ElectroTodos/ElectronicLoad/README.md

# ElectronicLoad
ElectronicLoad
youtube.com/electronicatodos/
https://www.youtube.com/playlist?list=PLbbu5mf7ZIfhO1j8X4gU5TwYUcYao87rT
