ElectroTodos/ElectronicLoad/PDFs/RevAPCB.pdf

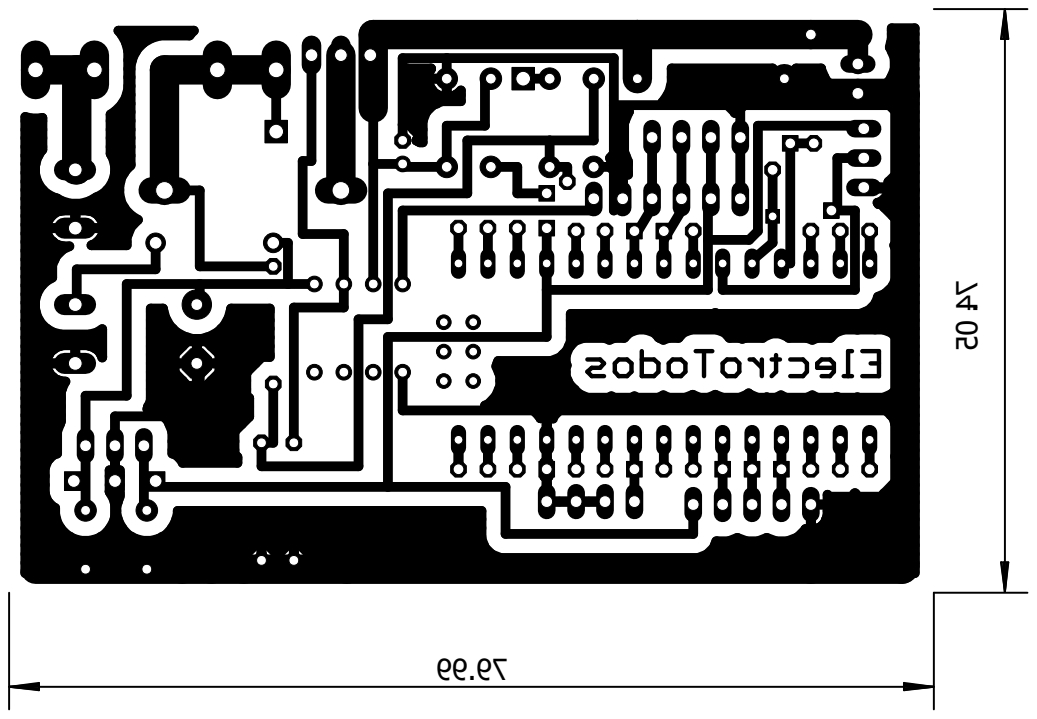
[picture p1: page 1]
