ElectroTodos/ElectronicLoad/PDFs/RevAPCBInfo.pdf

Q1

## IRLZ44Z

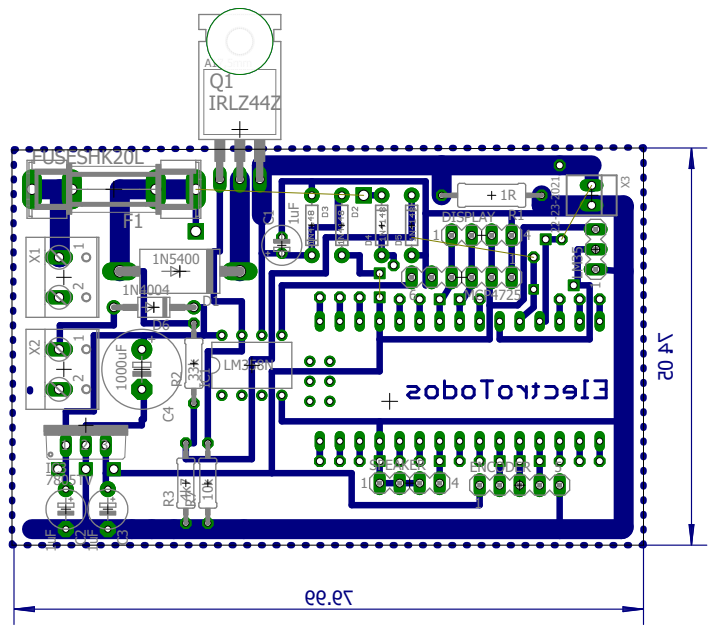
[picture p2: page 1]
