ElectroTodos/ElectronicLoad/PDFs/RevASch.pdf

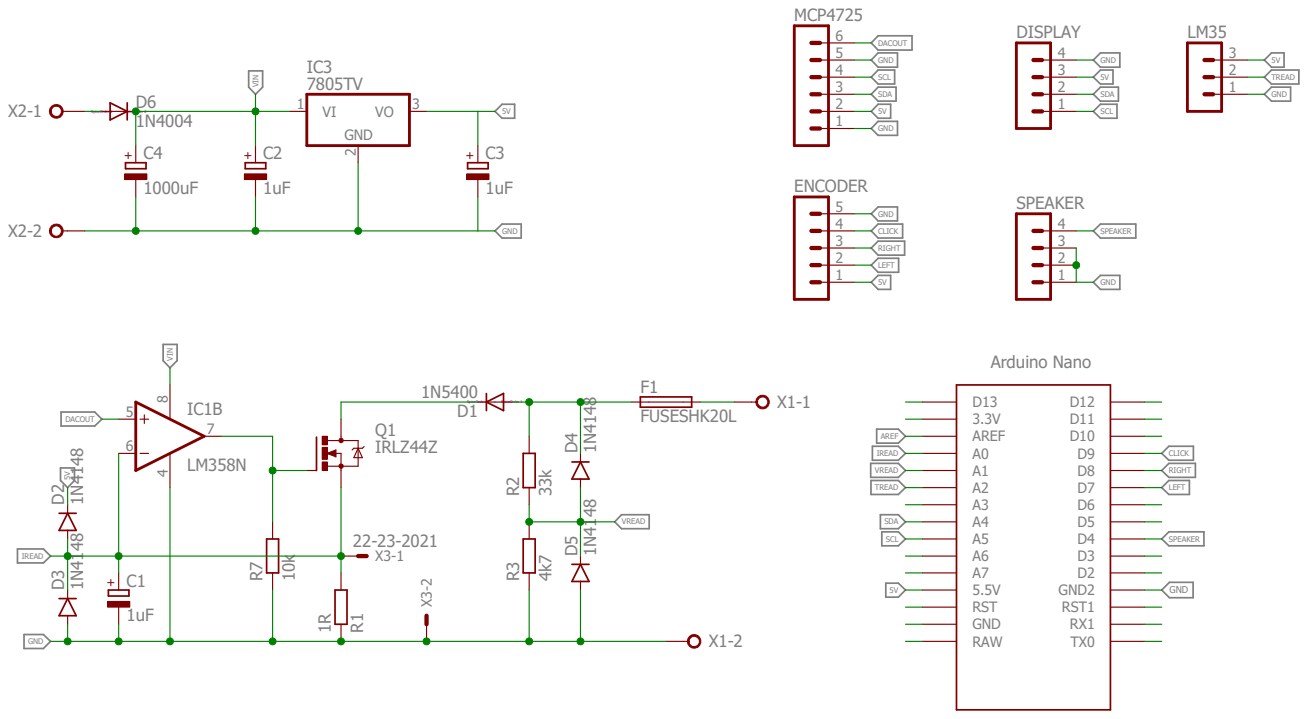
[picture p3: page 1]
