ElectroTodos/ElectronicLoad/RevA/RevA.brd

## EAGLE design RevA/RevA.brd (2016-07-01, an earlier design)

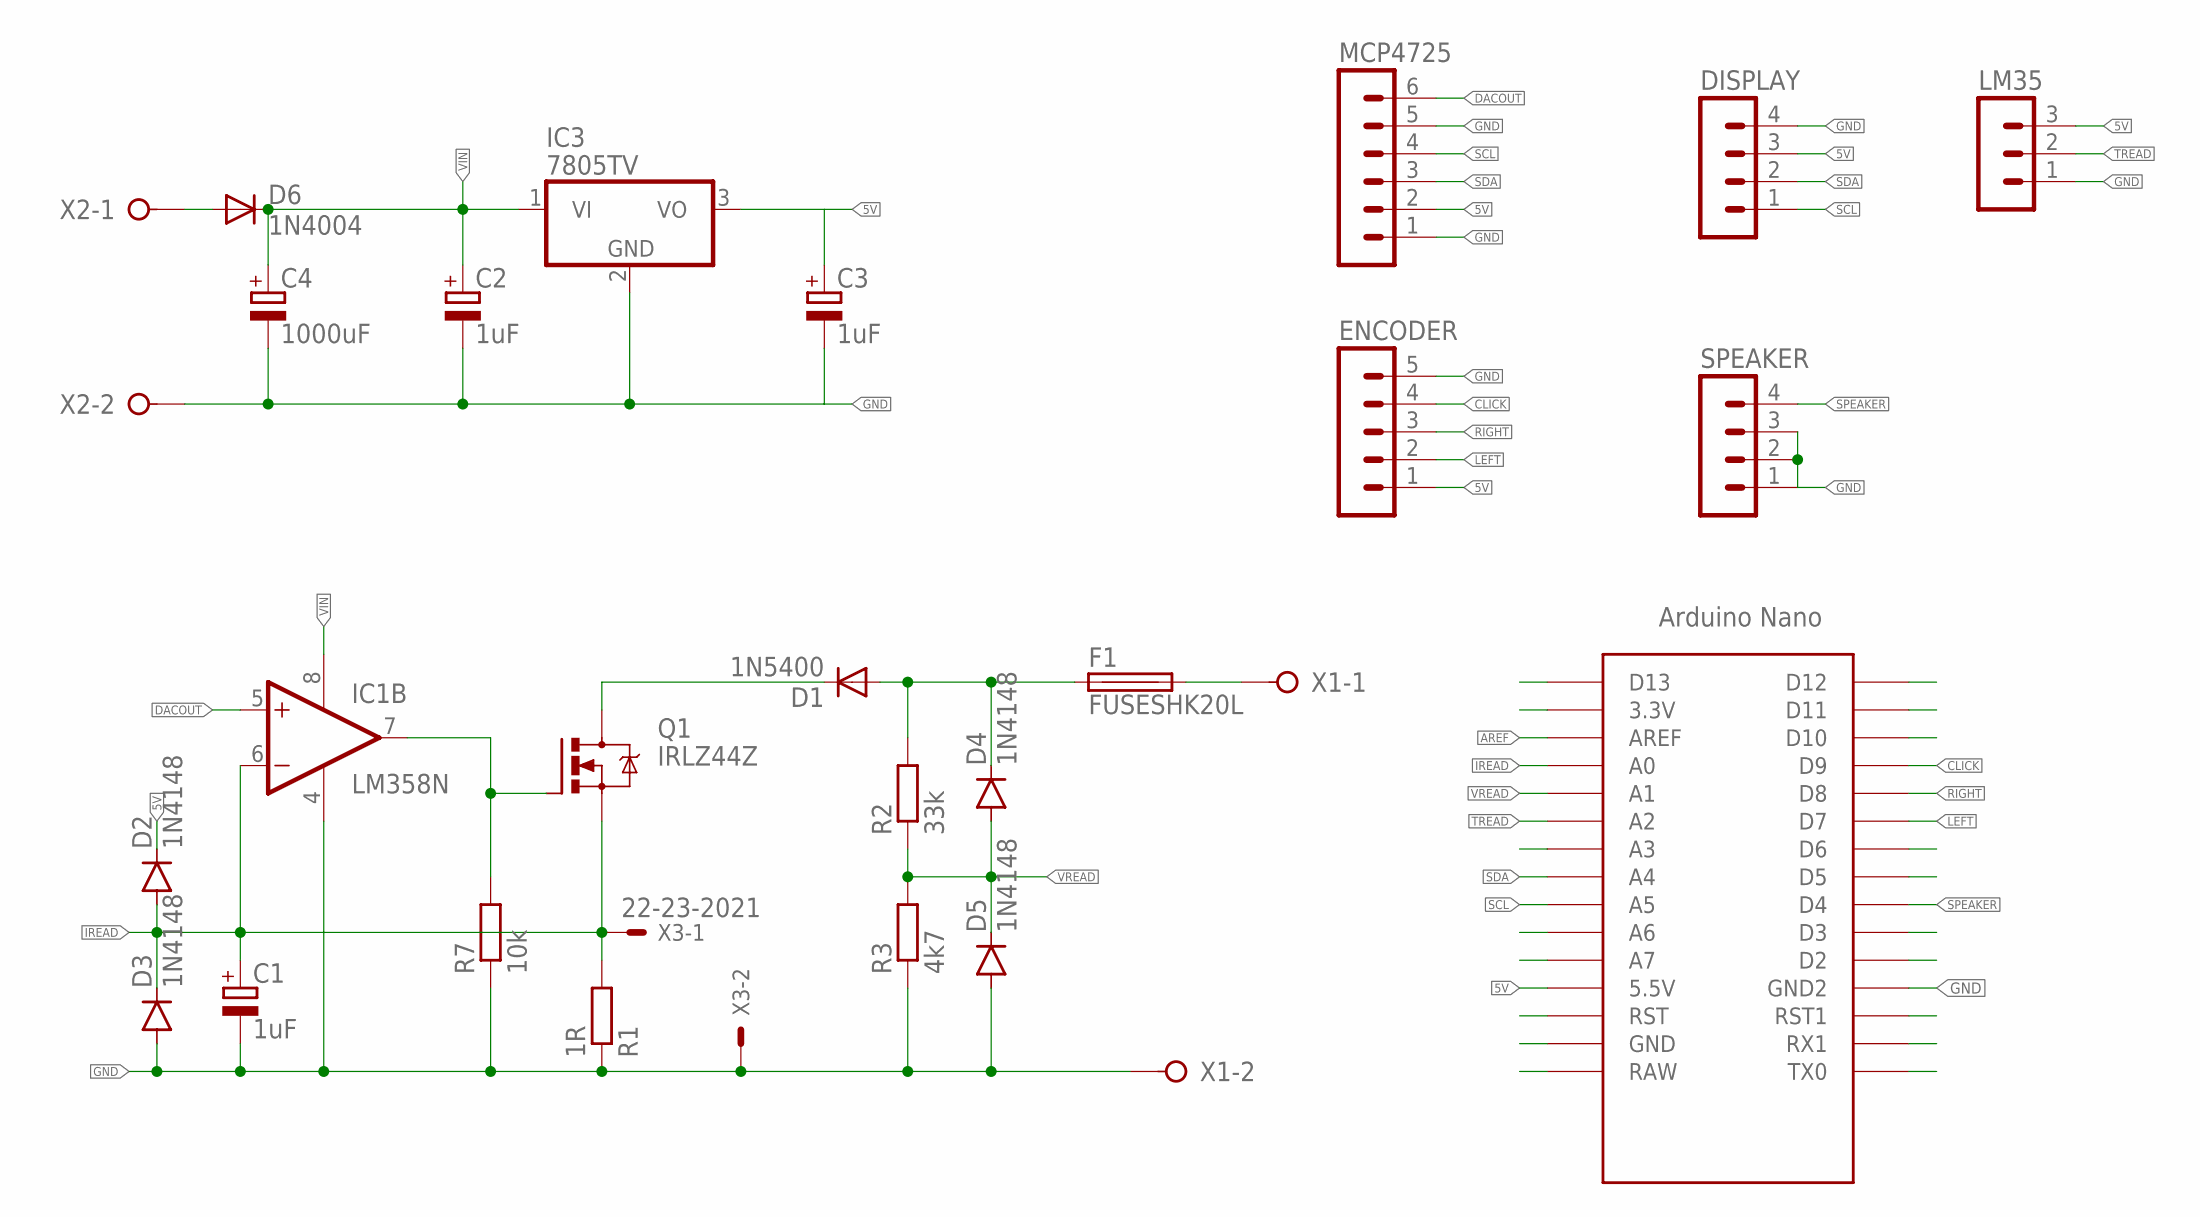
[picture p4: schematic RevA.sch]

Parts:
C1: 1uF; E2-5
C2, C3: 1uF; E5-5
C4: 1000uF; E5-10,5
D1: 1N5400; DO201-15
D2, D3, D4, D5: 1N4148; DIODE-1N4148
D6: 1N4004; DO41-10
DISPLAY: MA04-1
ENCODER: MA05-1
F1: FUSESHK20L; SHK20L
IC1: LM358N; DIL08
IC3: 7805TV; TO220V
LM35: MA03-1
MCP4725: MA06-1
Q1: IRLZ44Z; TO220BH
R1: 1R; 0309/12
R2: 33k; 0207/10
R3: 4k7; 0207/10
R7: 10k; 0207/10
SPEAKER: MA04-1
U$1: NANO
X1, X2: W237-02P; W237-132
X3: 22-23-2021

Connections:
5V: C3.+, D2.C, DISPLAY.3, ENCODER.1, IC3.3 (VO), LM35.3, MCP4725.2, U$1.5V (5.5V)
AREF: U$1.AREF
CLICK: ENCODER.4, U$1.D9
DACOUT: IC1.5 (+IN), MCP4725.6
GND: C1.-, C2.-, C3.-, C4.-, D3.A, D5.A, DISPLAY.4, ENCODER.5, IC1.4 (V-), IC3.2 (GND), LM35.1, MCP4725.1, MCP4725.5, R1.1, R3.1, R7.1, SPEAKER.1, SPEAKER.2, SPEAKER.3, U$1.GND1 (GND2), X1.2, X2.2, X3.2
IREAD: C1.+, D2.A, D3.C, IC1.6 (-IN), Q1.S, R1.2, U$1.A0, X3.1
LEFT: ENCODER.2, U$1.D7
unnamed: F1.2A (2), X1.1
unnamed: D1.A, D4.C, F1.1A (1), R2.2
unnamed: IC1.7 (OUT), Q1.G, R7.2
unnamed: D6.A, X2.1
unnamed: D1.C, Q1.D
RIGHT: ENCODER.3, U$1.D8
SCL: DISPLAY.1, MCP4725.4, U$1.A5
SDA: DISPLAY.2, MCP4725.3, U$1.A4
SPEAKER: SPEAKER.4, U$1.D4
TREAD: LM35.2, U$1.A2
VIN: C2.+, C4.+, D6.C, IC1.8 (V+), IC3.1 (VI)
VREAD: D4.A, D5.C, R2.1, R3.2, U$1.A1

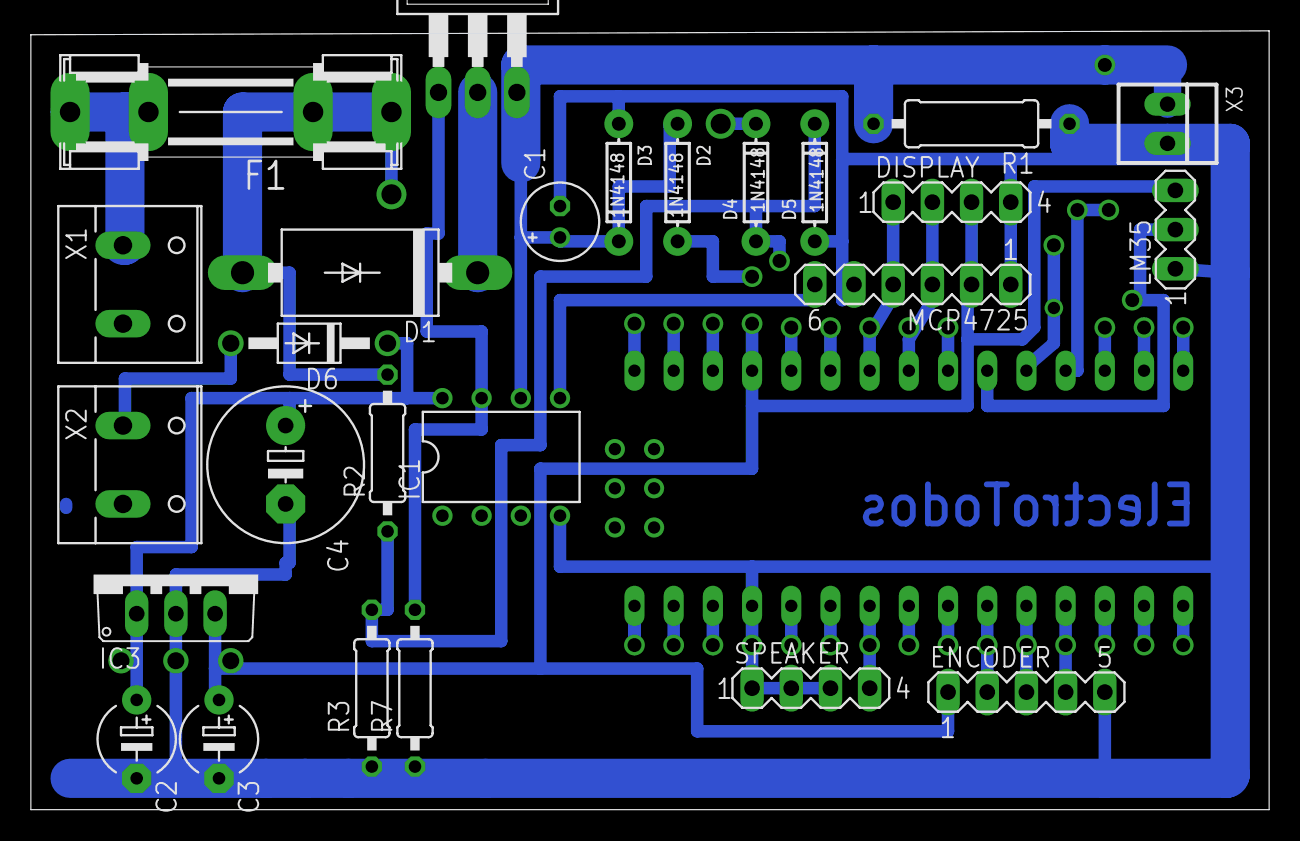
[picture p5: board RevA.brd from above]

Board: 2 copper layers, 80.2 x 50.5 mm, 27 parts (0 on the bottom side), 18 nets.
